DiogodosSantos/projetor_inteligente/README.md

# projetor_inteligente
Arquivos importantes e códigos-fonte do trabalho de conclusao de curso: Firefly.

Criadores:  Diogo Batista dos Santos & Eric Nozomi Tatsuta
