DiogodosSantos/projetor_inteligente/(list of files, drawings)

Other design files:
Hardware/projeto dlp/DLP4500-C350REF_ESD.opj
