DiogodosSantos/projetor_inteligente/Hardware/projeto bridge/Bridge - Gerber/dsi_to_lvds_bridge.kicad_pcb

## KiCad design Hardware/projeto bridge/Bridge - Gerber/dsi_to_lvds_bridge.kicad_pcb (2018-12-18)

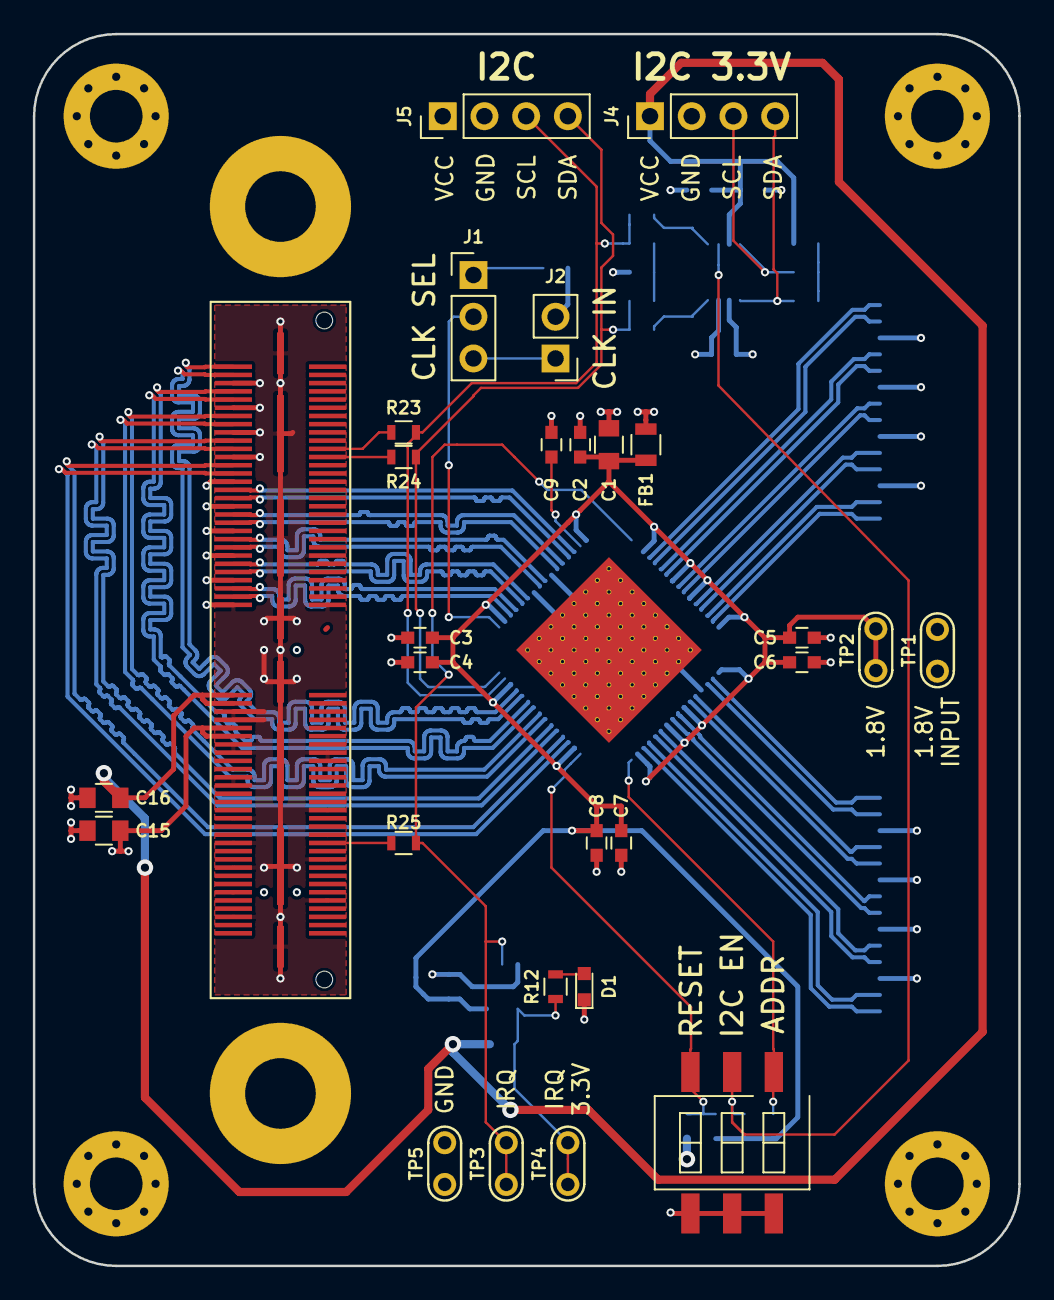
[picture p11: board dsi_to_lvds_bridge.kicad_pcb from above]

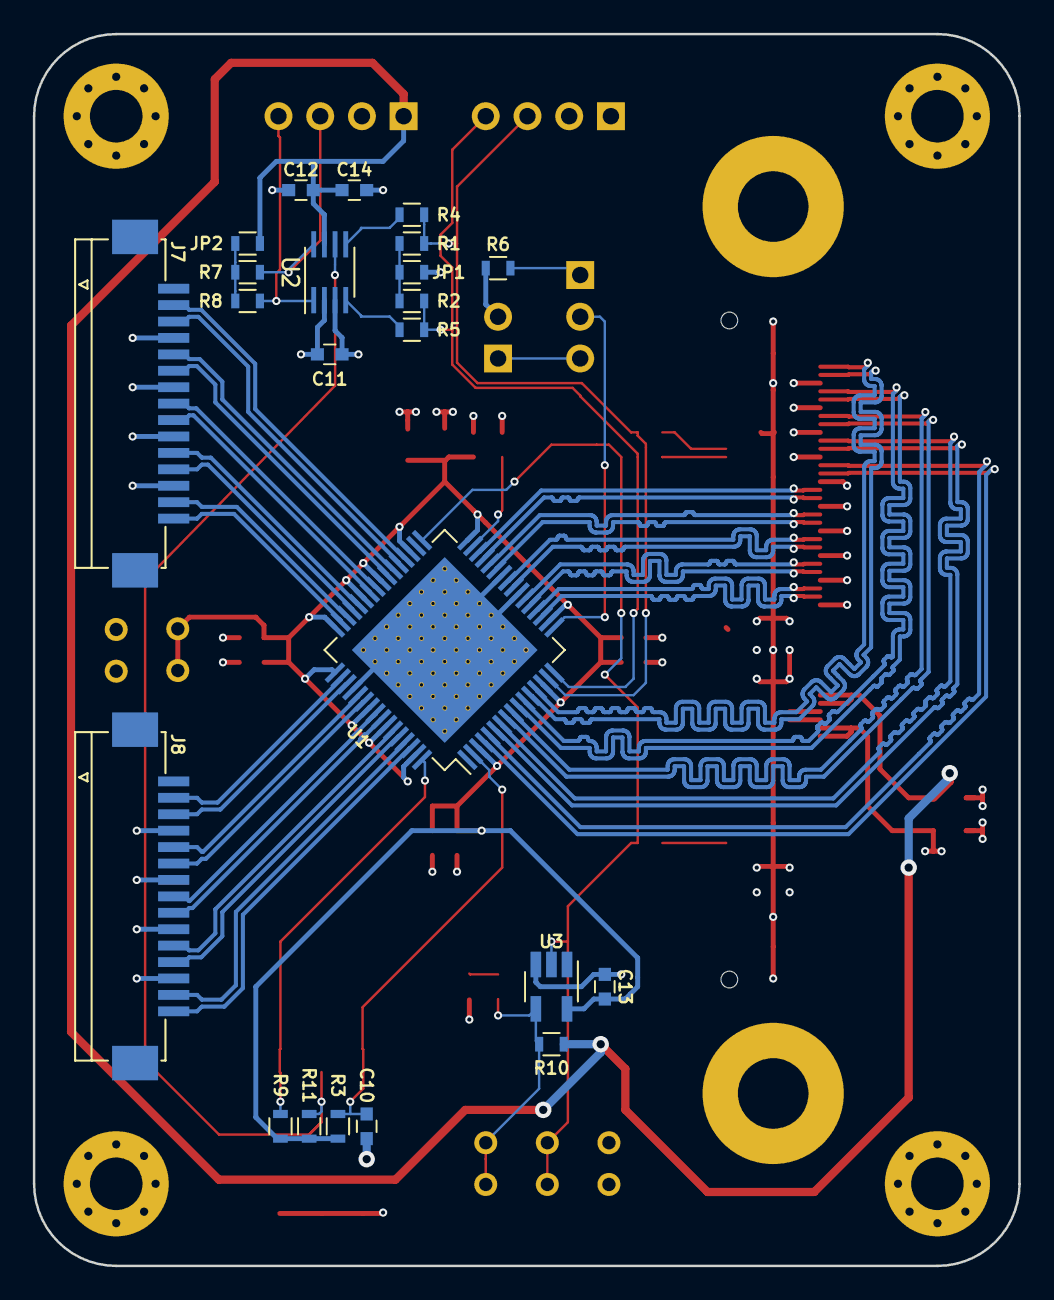
[picture p12: board dsi_to_lvds_bridge.kicad_pcb from below]

Board: 4 copper layers, 60.0 x 75.0 mm, 57 parts (23 on the bottom side), 65 nets.

Parts:
C1, C15, C16: 10µF; C_0805
C2, C9, C12: 1µF; C_0603
C3, C5, C7: 10nF; C_0603
C4, C6, C8, C11, C13, C14: 100nF; C_0603
C10: 220nF; C_0603
D1: LED; LED_0603
FB1: 220 @ 100MHz; L_0805
H1, H2, H3, H4: M3; MountingHole_3.2mm_M3_Pad_Via
H5, H6: 4.24; MountingHole_4.3mm_M4_Pad
J1: CLK_SEL; Pin_Header_Straight_1x03_Pitch2.54mm
J2: EXT_CLK; Pin_Header_Straight_1x02_Pitch2.54mm
J3: DIL6; SW_DIP_x3_W8.61mm_Slide_LowProfile
J4: I2C_3V3; Pin_Header_Straight_1x04_Pitch2.54mm
J5: I2C_1V8; Pin_Header_Straight_1x04_Pitch2.54mm
J6: QSH-060-01-X-D-A
J7: LVDS_A; 052271-1579
J8: LVDS_B; 052271-1579
JP1: I2C_PULL; R_0603
JP2: I2C_3V3_PULL; R_0603
R1, R2, R7, R8, R9, R11: 4.7K; R_0603
R3: R; R_0603
R4, R5, R12, R23, R24, R25: 0; R_0603
R6: 10K; R_0603
R10: 1K; R_0603
TP1: 1V8_IN; Test_Point
TP2: 1V8; Test_Point
TP3: IRQ; Test_Point
TP4: IRQ_3V3; Test_Point
TP5: GND; Test_Point
U1: SN65DSI85-Q1; HTQFP-64_1EP_10x10mm_Pitch0.5mm_ThermalPad
U2: TXS0102; SSOP-8_2.95x2.8mm_Pitch0.65mm
U3: SN74LVC1G07; SOT-23-5_HandSoldering

Connections:
+1V8: C1.1, C2.1, C3.1, C4.1, C5.1, C6.1, C7.1, C8.1, C13.1, FB1.2, R3.1, R9.1, R11.1, TP2.1, U1.3, U1.14, U1.18, U1.32, U1.35, U1.40, U1.43, U1.48, U1.49, U1.55, U1.58, U1.63, U3.5
+1V8_INPUT: C11.1, C15.1, FB1.1, J5.1, J6.69, J6.71, JP1.2, TP1.1, U2.3
+3V3: C12.1, C14.1, C16.1, J4.1, J6.61, J6.63, JP2.2, R10.1, U2.7
/ADDR: J3.1, R9.2, U1.64
/I2C_EN: J3.2, R11.2, U2.6
/REFCLK: J1.2, U1.17
DSI_A0_N: J6.55, U1.20
DSI_A0_P: J6.57, U1.19
DSI_A1_N: J6.49, U1.22
DSI_A1_P: J6.51, U1.21
DSI_A2_N: J6.37, U1.28
DSI_A2_P: J6.39, U1.27
DSI_A3_N: J6.31, U1.30
DSI_A3_P: J6.33, U1.29
DSI_ACLK_N: J6.43, U1.25
DSI_ACLK_P: J6.45, U1.24
DSI_B0_N: J6.25, U1.5
DSI_B0_P: J6.27, U1.4
DSI_B1_N: J6.19, U1.7
DSI_B1_P: J6.21, U1.6
DSI_B2_N: J6.7, U1.11
DSI_B2_P: J6.9, U1.10
DSI_B3_N: J6.1, U1.13
DSI_B3_P: J6.3, U1.12
DSI_BCLK_N: J6.13, U1.9
DSI_BCLK_P: J6.15, U1.8
GND: C1.2, C2.2, C3.2, C4.2, C5.2, C6.2, C7.2, C8.2, C9.2, C10.2, C11.2, C12.2, C13.2, C14.2, C15.2, C16.2, D1.1, H1.1, H2.1, H3.1, H4.1, J2.2, J3.4, J3.5, J3.6, J4.2, J5.2, J6.5, J6.11, J6.17, J6.23, J6.29, J6.35, J6.41, J6.47, J6.48, J6.52, J6.53, J6.59, J6.60, J6.65, J6.67, J6.70, J6.73, J6.75, J6.76, J6.78, J6.81, J6.83, J6.90, J6.91, J6.96, J6.97, J6.102, J6.103, J6.109, J6.112, J6.115, J6.121, J6.122, J6.123, J6.124, J6.125, J6.126, J6.127, J6.128, J7.4, J7.7, J7.10, J7.13, J8.4, J8.7, J8.10, J8.13, R6.1, TP5.1, U1.23, U1.26, U1.52, U1.65, U2.2, U3.3
I2C_3V3_SCL: J4.3, R7.2, U2.8
I2C_3V3_SDA: J4.4, R8.2, U2.1
I2C_SCL: J5.3, R1.2, R4.1, R23.2, U1.15
I2C_SDA: J5.4, R2.2, R5.2, R24.1, U1.16
IRQ: R25.2, TP3.1, U1.33, U3.2
IRQ_3V3: R10.2, R12.1, TP4.1, U3.4
LVDS_A0_N: J7.15, U1.47
LVDS_A0_P: J7.14, U1.46
LVDS_A1_N: J7.12, U1.45
LVDS_A1_P: J7.11, U1.44
LVDS_A2_N: J7.9, U1.42
LVDS_A2_P: J7.8, U1.41
LVDS_A3_N: J7.3, U1.37
LVDS_A3_P: J7.2, U1.36
LVDS_ACLK_N: J7.6, U1.39
LVDS_ACLK_P: J7.5, U1.38
LVDS_B0_N: J8.15, U1.62
LVDS_B0_P: J8.14, U1.61
LVDS_B1_N: J8.12, U1.60
LVDS_B1_P: J8.11, U1.59
LVDS_B2_N: J8.9, U1.57
LVDS_B2_P: J8.8, U1.56
LVDS_B3_N: J8.3, U1.51
LVDS_B3_P: J8.2, U1.50
LVDS_BCLK_N: J8.6, U1.54
LVDS_BCLK_P: J8.5, U1.53
unnamed: C9.1, U1.31
unnamed: D1.2, R12.2
unnamed: J1.1, R6.2
unnamed: J1.3, J2.1
unnamed: J6.22, R23.1
unnamed: J6.24, R24.2
unnamed: J6.98, R25.1
unnamed: JP1.1, R1.1, R2.1
unnamed: JP2.1, R7.1, R8.1
unnamed: R4.2, U2.5
unnamed: R5.1, U2.4
RESETN: C10.1, J3.3, R3.2, U1.2
